Ihysol/Hexleaf_Hardware/hexleaf.kicad_pcb

## KiCad design hexleaf.kicad_pcb (2022-05-22)

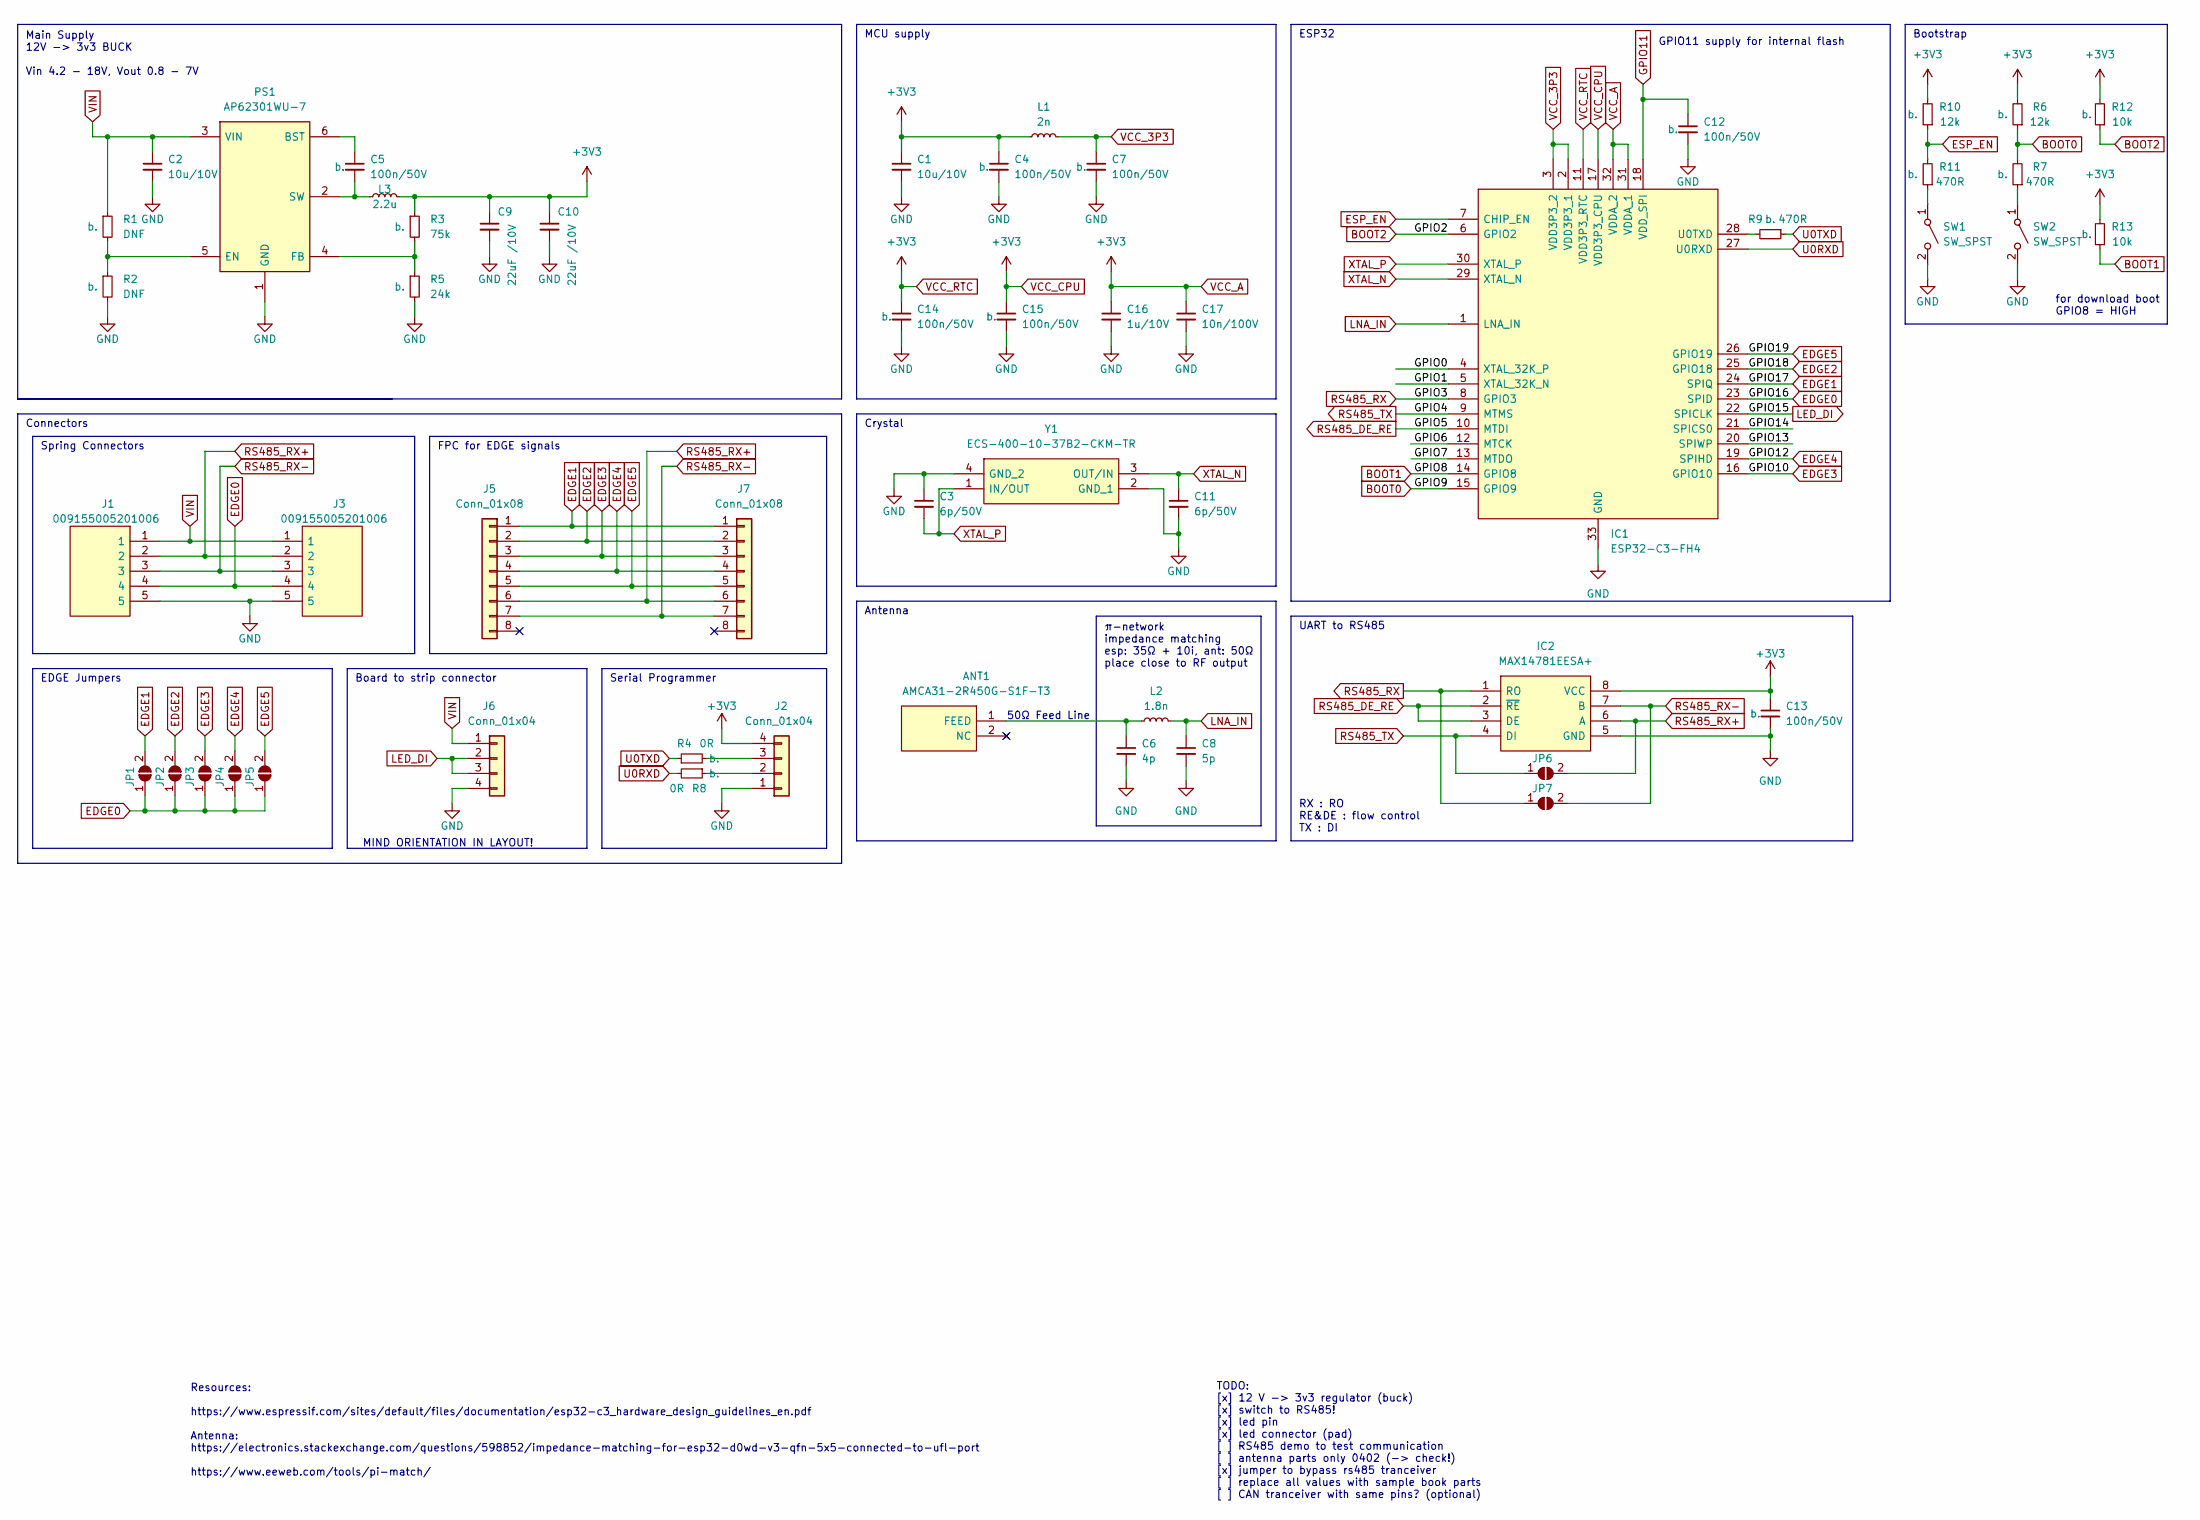
[picture p1: schematic hexleaf.kicad_sch]

Parts:
ANT1: AMCA31-2R450G-S1F-T3; ANTC3216X140N; Mouser Part Number 815-CA312R450GS1FT3
C1, C2: 10u/10V; R_0805_2012Metric
C3, C11: 6p/50V; C_0402_1005Metric
C4, C5, C7, C12, C13, C14, C15: 100n/50V; R_0603_1608Metric
C6: 4p; C_0402_1005Metric
C8: 5p; C_0402_1005Metric
C9, C10: 22uF /10V; C_0603_1608Metric; Mouser Part Number 187-CL10A226MP8NUNE
C16: 1u/10V; R_0603_1608Metric
C17: 10n/100V; R_0805_2012Metric
IC1: ESP32-C3-FH4; QFN50P500X500X90-33N-D; Mouser Part Number 356-ESP32-C3FH4
IC2: MAX14781EESA+; SOIC127P600X175-8N; Mouser Part Number 700-MAX14781EESA+
J1, J3: 009155005201006; Mouser Part Number 581-009155005201006
J2: Conn_01x04; PinHeader_1x04_P2.54mm_Vertical
J5, J7: Conn_01x08
J6: Conn_01x04; WS2815_Strip_4P_Full
JP1, JP2, JP3, JP4, JP5, JP6, JP7: SolderJumper_2_Open; SolderJumper-2_P1.3mm_Open_TrianglePad1.0x1.5mm
L1: 2n; C_0402_1005Metric
L2: 1.8n; L_0402_1005Metric
L3: 2.2u; L_5024
PS1: AP62301WU-7; SOT95P280X100-6N; Mouser Part Number 621-AP62301WU-7
R1, R2: DNF; R_0402_1005Metric
R3: 75k; R_0402_1005Metric
R4, R8: 0R; R_0402_1005Metric
R5: 24k; R_0402_1005Metric
R6, R10: 12k; R_0402_1005Metric
R7, R9, R11: 470R; R_0402_1005Metric
R12, R13: 10k; R_0402_1005Metric
SW1, SW2: SW_SPST; KXT3-1831561
Y1: ECS-400-10-37B2-CKM-TR; ECS4001037B2CKMTR; Mouser Part Number 520-400-10-37B2CKMTR

Connections:
/GPIO0: IC1.4 (XTAL_32K_P)
/GPIO1: IC1.5 (XTAL_32K_N)
/GPIO6: IC1.12 (MTCK)
/GPIO7: IC1.13 (MTDO)
/GPIO13: IC1.20 (SPIWP)
/GPIO14: IC1.21 (SPICS0)
BOOT0: IC1.15 (GPIO9), R6.1, R7.2
BOOT1: IC1.14 (GPIO8), R13.1
BOOT2: IC1.6 (GPIO2), R12.1
EDGE0: IC1.23 (SPID), J1.4, J3.4, JP1.1 (A), JP2.1 (A), JP3.1 (A), JP4.1 (A), JP5.1 (A)
EDGE1: IC1.24 (SPIQ), J5.1, J7.1, JP1.2 (B)
EDGE2: IC1.25 (GPIO18), J5.2, J7.2, JP2.2 (B)
EDGE3: IC1.16 (GPIO10), J5.3, J7.3, JP3.2 (B)
EDGE4: IC1.19 (SPIHD), J5.4, J7.4, JP4.2 (B)
EDGE5: IC1.26 (GPIO19), J5.5, J7.5, JP5.2 (B)
ESP_EN: IC1.7 (CHIP_EN), R10.1, R11.2
GND: C1.2, C2.2, C3.1, C4.2, C6.2, C7.2, C8.2, C9.2, C10.2, C11.2, C12.2, C13.2, C14.2, C15.2, C16.2, C17.2, IC1.33 (GND), IC2.5 (GND), J1.5, J2.1, J3.5, J6.4, PS1.1 (GND), R2.2, R5.2, SW1.2 (B), SW2.2 (B), Y1.2 (GND_1), Y1.4 (GND_2)
GPIO11: C12.1, IC1.18 (VDD_SPI)
LED_DI: IC1.22 (SPICLK), J6.2, J6.3
LNA_IN: C8.1, IC1.1 (LNA_IN), L2.2
unnamed: ANT1.1 (FEED), C6.1, L2.1
unnamed: C5.1, PS1.6 (BST)
unnamed: C5.2, L3.1, PS1.2 (SW)
unnamed: IC1.28 (U0TXD), R9.2
unnamed: J2.2, R8.1
unnamed: J2.3, R4.2
unnamed: PS1.4 (FB), R3.2, R5.1
unnamed: PS1.5 (EN), R1.2, R2.1
unnamed: R7.1, SW2.1 (A)
unnamed: R11.1, SW1.1 (A)
RS485_DE_RE: IC1.10 (MTDI), IC2.2 (~RE), IC2.3 (DE)
RS485_RX: IC1.8 (GPIO3), IC2.1 (RO), JP7.1 (A)
RS485_RX+: IC2.6 (A), J1.2, J3.2, J5.6, J7.6, JP6.2 (B)
RS485_RX-: IC2.7 (B), J1.3, J3.3, J5.7, J7.7, JP7.2 (B)
RS485_TX: IC1.9 (MTMS), IC2.4 (DI), JP6.1 (A)
U0RXD: IC1.27 (U0RXD), R8.2
U0TXD: R4.1, R9.1
VCC_3P3: C7.1, IC1.2 (VDD3P3_1), IC1.3 (VDD3P3_2), L1.2
VCC_A: C1.1, C4.1, C9.1, C10.1, C13.1, C14.1, C15.1, C16.1, C17.1, IC1.11 (VDD3P3_RTC), IC1.17 (VDD3P3_CPU), IC1.31 (VDDA_1), IC1.32 (VDDA_2), IC2.8 (VCC), J2.4, L1.1, L3.2, R3.1, R6.2, R10.2, R12.2, R13.2
VIN: C2.1, J1.1, J3.1, J6.1, PS1.3 (VIN), R1.1
XTAL_N: C11.1, IC1.29 (XTAL_N), Y1.3 (OUT/IN)
XTAL_P: C3.2, IC1.30 (XTAL_P), Y1.1 (IN/OUT)

Notes on the sheet:
Connectors
π-network impedance matching esp: 35Ω + 10i, ant: 50Ω place close to RF output
Spring Connectors
RX : RO RE&DE : flow control TX : DI
Main Supply 12V -> 3v3 BUCK Vin 4.2 - 18V, Vout 0.8 - 7V
FPC for EDGE signals
MIND ORIENTATION IN LAYOUT!
GPIO11 supply for internal flash
Serial Programmer
Board to strip connector
for download boot GPIO8 = HIGH
MCU supply
EDGE Jumpers
Antenna
ESP32
Resources: https://www.espressif.com/sites/default/files/documentation/esp32-c3_hardware_design_guidelines_en.pdf Antenna: https://electronics.stackexchange.com/questions/598852/impedance-matching-for-esp32-d0wd-v3-qfn-5x5-connected-to-ufl-port https://www.eeweb.com/tools/pi-match/
UART to RS485
Crystal
Bootstrap
50Ω Feed Line
TODO: [x] 12 V -> 3v3 regulator (buck) [x] switch to RS485! [x] led pin [x] led connector (pad) [ ] RS485 demo to test communication [ ] antenna parts only 0402 (-> check!) [x] jumper to bypass rs485 tranceiver [ ] replace all values with sample book parts [ ] CAN tranceiver with same pins? (option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

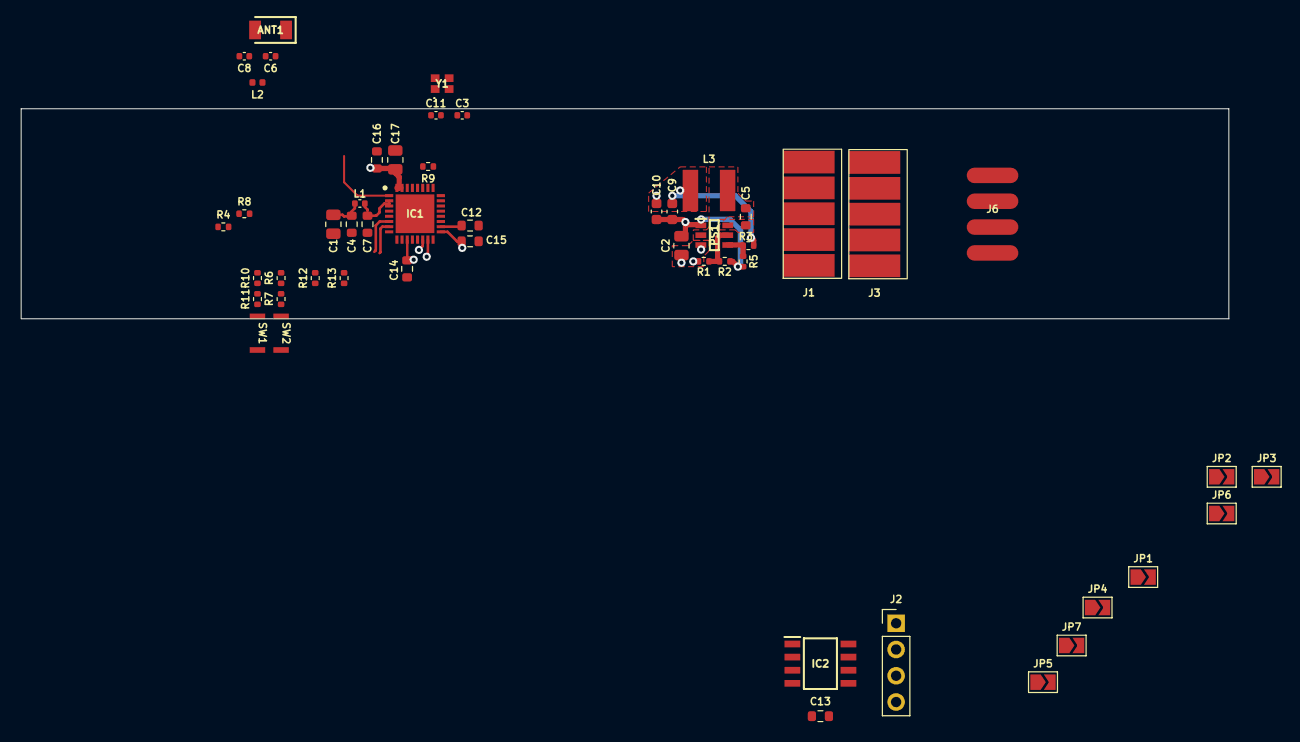
[picture p2: board hexleaf.kicad_pcb from above]

Board: 4 copper layers, 116.8 x 20.3 mm, 51 parts (0 on the bottom side), 36 nets.
