Ihysol/Hexleaf_Hardware/(commit log)

2022-05-07 added TODO
    [hexleaf.kicad_sch]
2022-05-07 added spring connector libs
2022-05-07 added spring connectors & started setup for edge-system
    [hexleaf.kicad_sch]
2022-05-08 antenna parts
    [hexleaf.kicad_sch]
2022-05-08 updated todo
    [hexleaf.kicad_sch]
2022-05-09 added connectors
    [hexleaf.kicad_sch]
2022-05-10 added 5 pin connector
    [hexleaf.kicad_sch]
2022-05-11 moved EDGE signal from GPIO8(strapping pin)
    [hexleaf.kicad_sch]
2022-05-11 added strapping pin
    [hexleaf.kicad_sch]
2022-05-12 uart1 planning
2022-05-21 redone gpio0 labels + added rs485 pins
    [hexleaf.kicad_sch]
2022-05-21 led pins and RS485 bypass jumper
    [hexleaf.kicad_sch]
2022-05-21 added buck
    [hexleaf.kicad_sch]
2022-05-21 changed parts and ordered first batch for prototyping
    [hexleaf.kicad_sch]
2022-05-21 added alternative to RS485 ic
    [hexleaf.kicad_sch]
2022-05-22 started layout
    [hexleaf.kicad_pcb, hexleaf.kicad_sch]
2022-08-03 updated schematic (crystal symbol)
    [hexleaf.kicad_sch, hexleaf.sch]
